TheOpenSI/SmartGate/test_frame.jpg

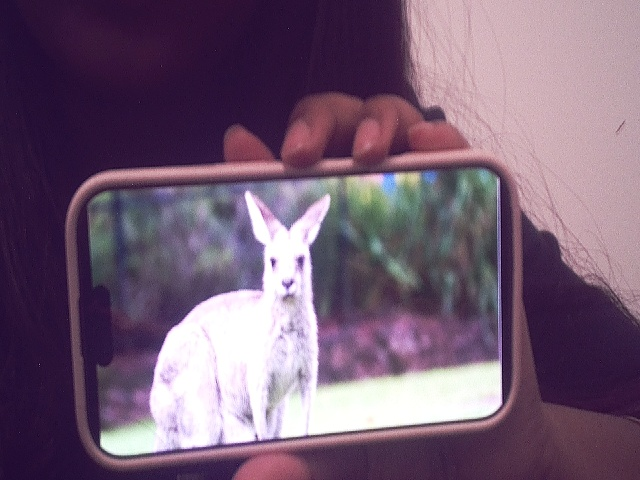
test_frame.jpg
