TheOpenSI/SmartGate/src/web-app/wwwroot/images/oranguton.jpg

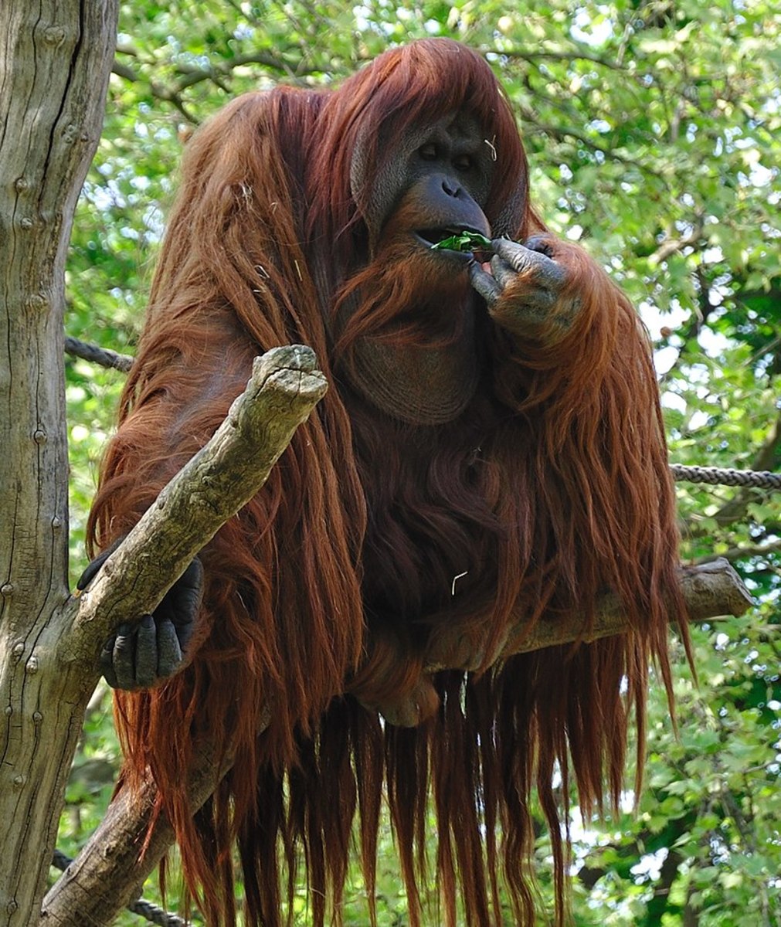
src/web-app/wwwroot/images/oranguton.jpg
