TheOpenSI/SmartGate/src/web-app/wwwroot/images/bongo-antelope.jpg

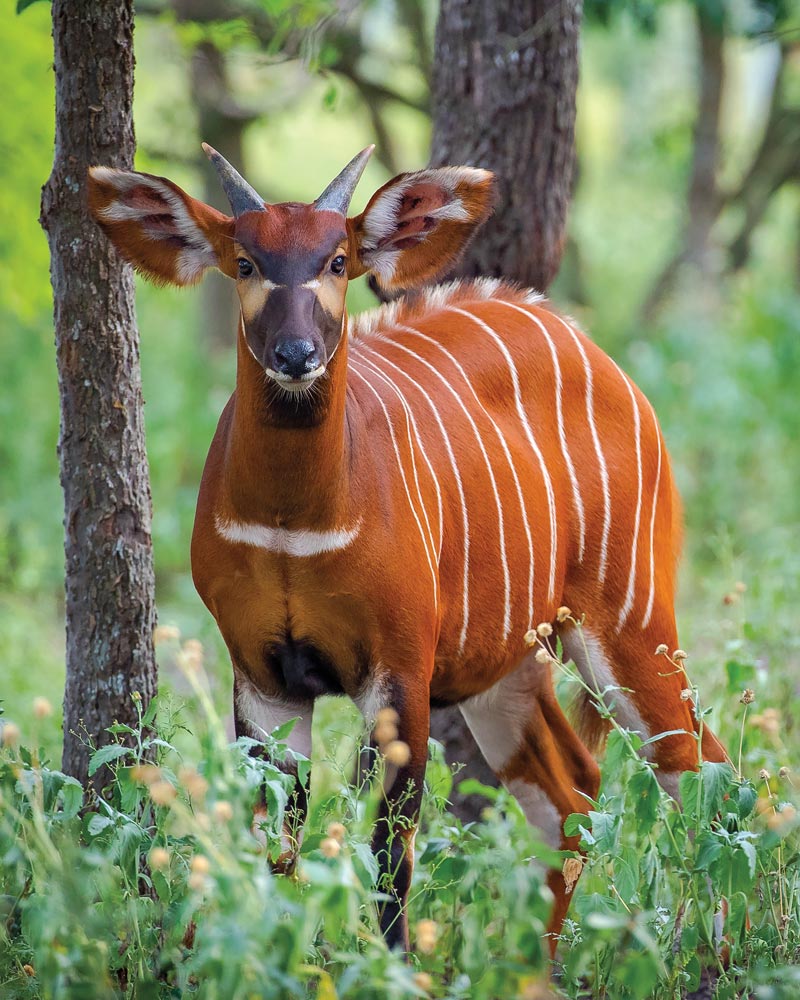
src/web-app/wwwroot/images/bongo-antelope.jpg
