TheOpenSI/SmartGate/src/web-app/wwwroot/images/elephant.jpeg

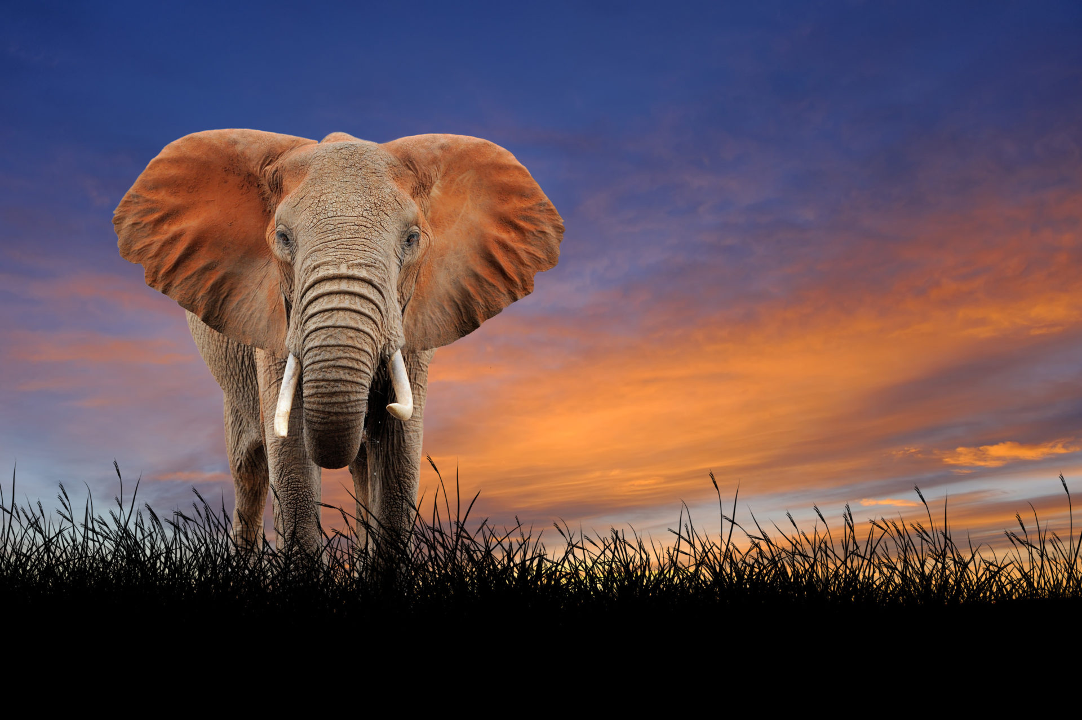
src/web-app/wwwroot/images/elephant.jpeg
