TheOpenSI/SmartGate/src/web-app/wwwroot/images/forest-background.jpg

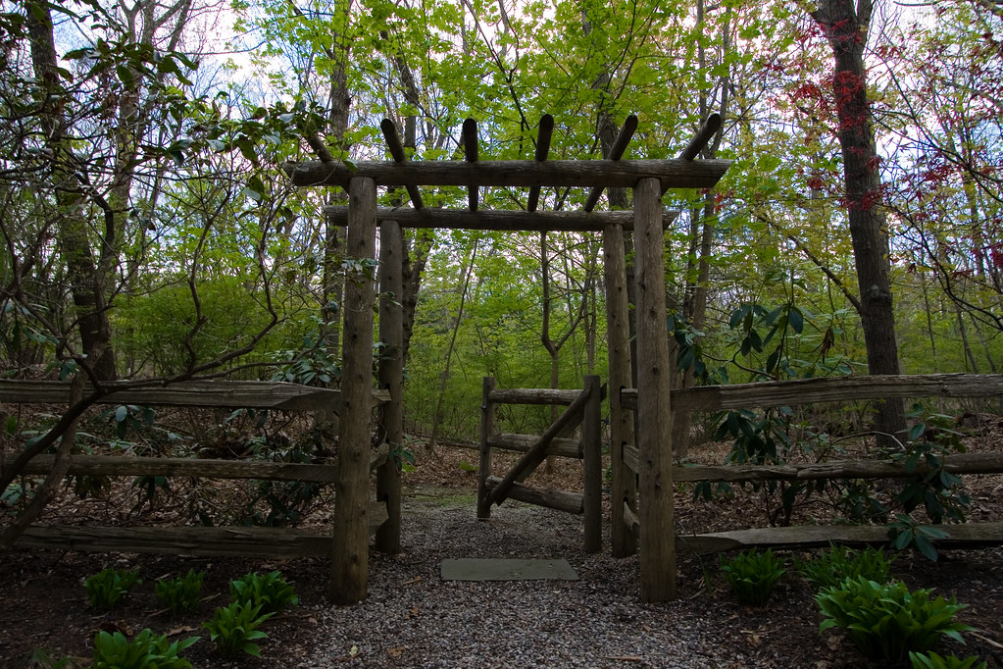
src/web-app/wwwroot/images/forest-background.jpg
