TheOpenSI/SmartGate/src/web-app/wwwroot/images/panda.jpg

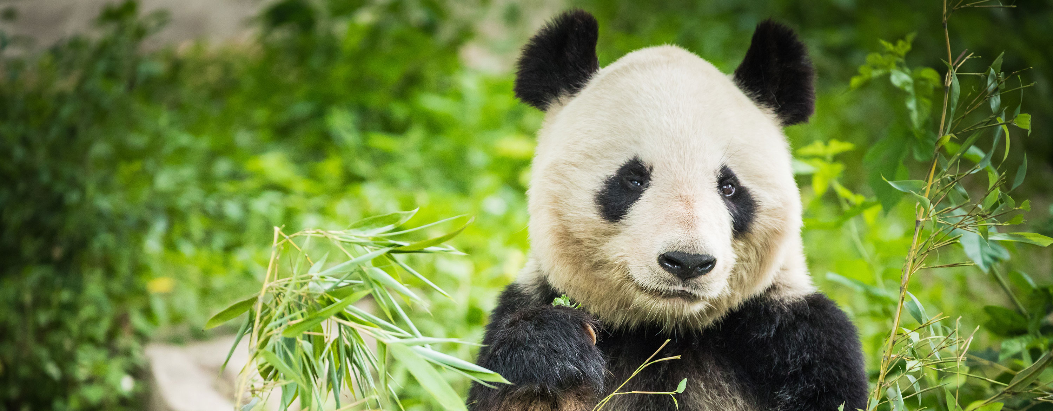
src/web-app/wwwroot/images/panda.jpg
