TheOpenSI/SmartGate/src/web-app/wwwroot/images/red-panda.jpg

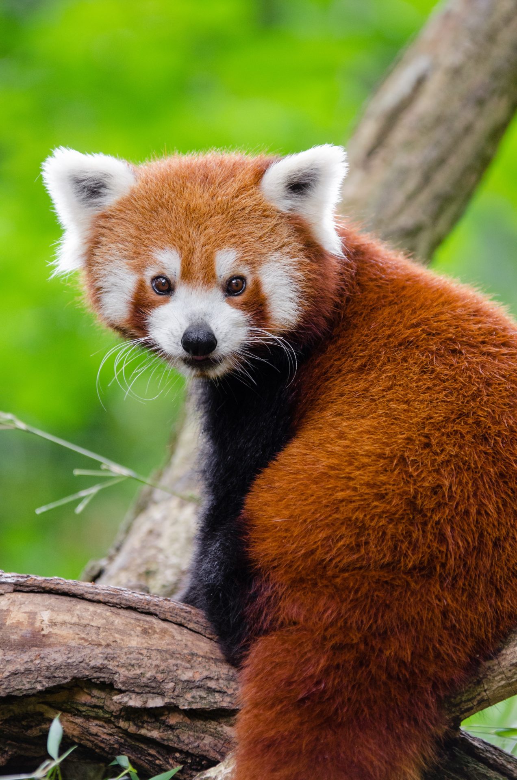
src/web-app/wwwroot/images/red-panda.jpg
