TheOpenSI/SmartGate/src/web-app/wwwroot/images/red-ruffed-lemur.jpg

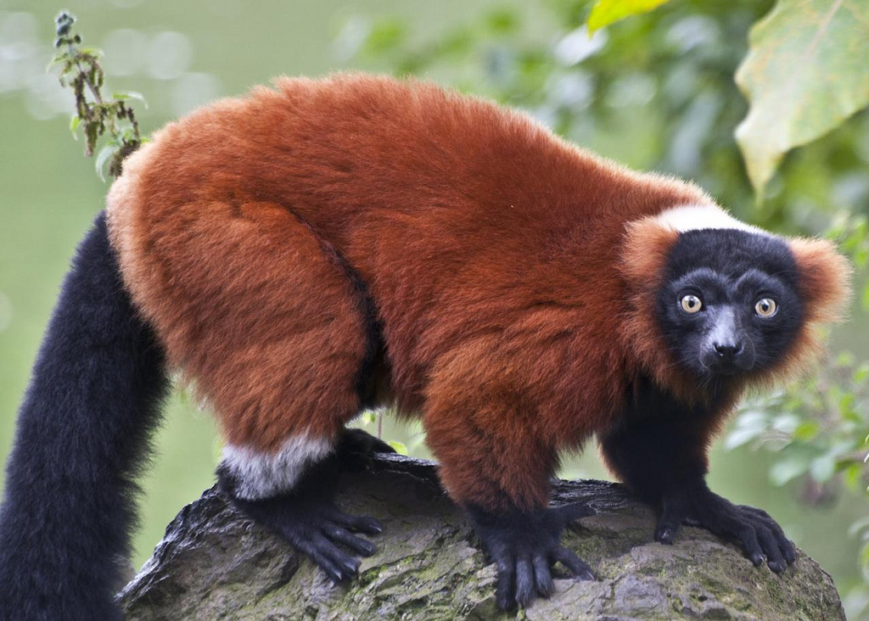
src/web-app/wwwroot/images/red-ruffed-lemur.jpg
