TheOpenSI/SmartGate/src/web-app/wwwroot/images/rihno.jpg

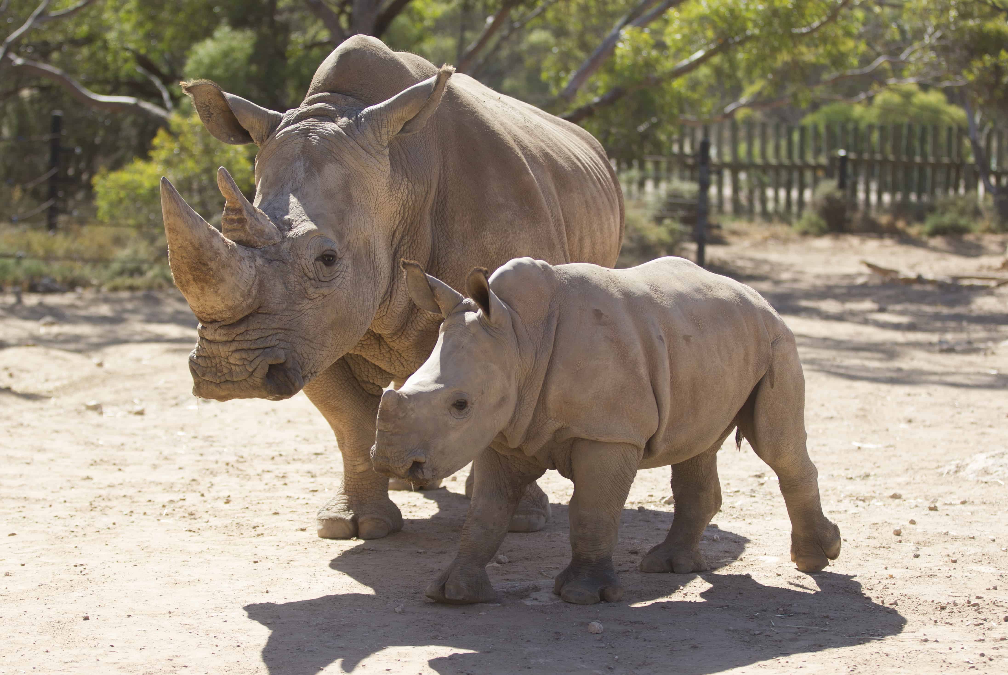
src/web-app/wwwroot/images/rihno.jpg
