TheOpenSI/SmartGate/src/web-app/wwwroot/images/wild_fox.jpg

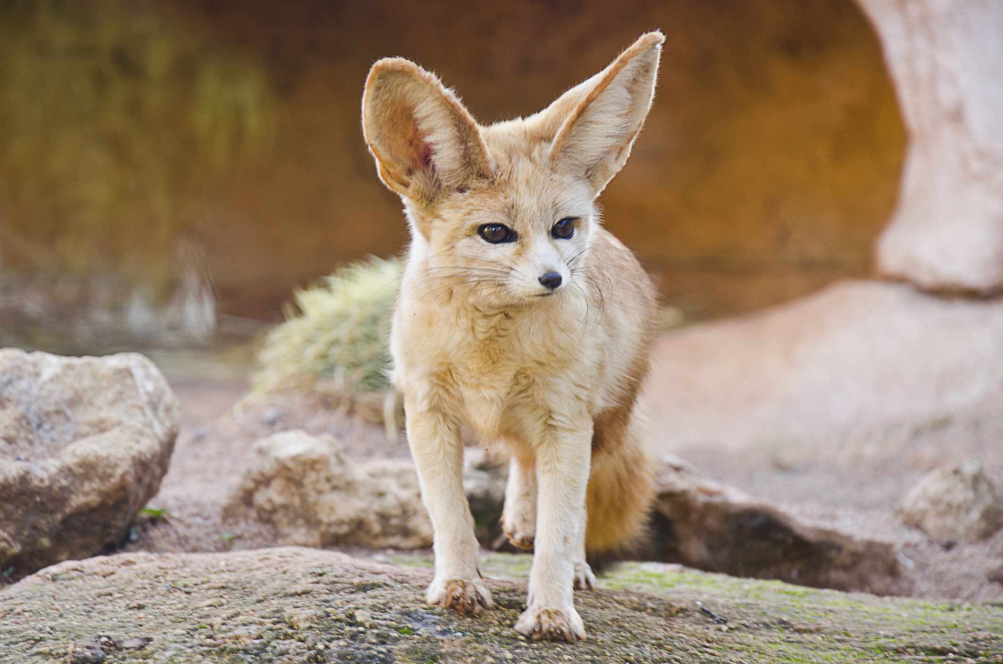
src/web-app/wwwroot/images/wild_fox.jpg
