TheOpenSI/SmartGate/src/web/background_placeholder.jpg

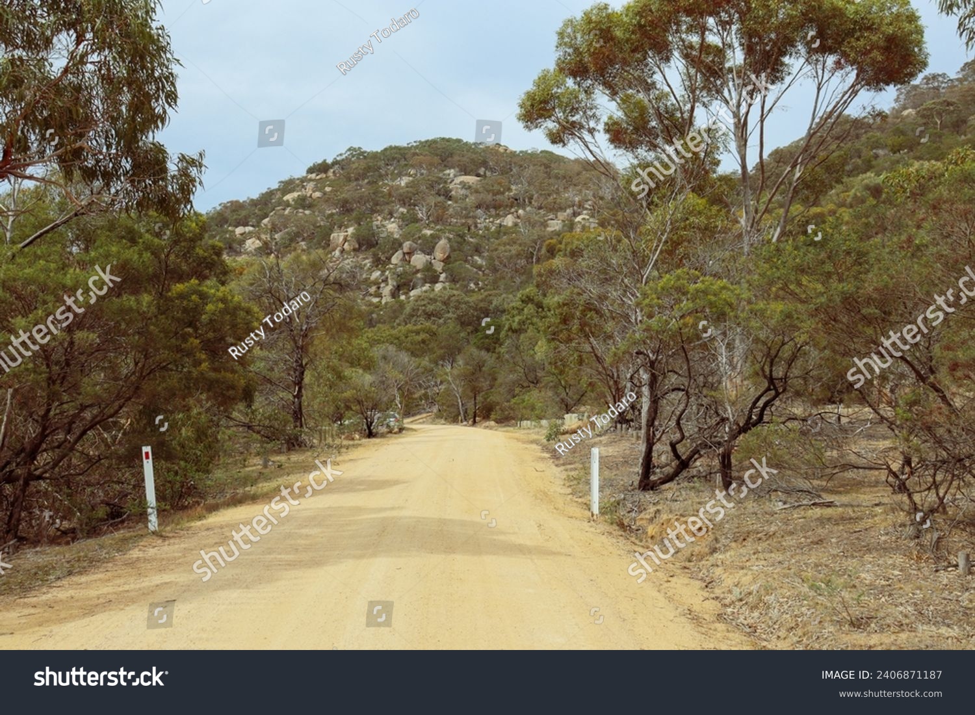
src/web/background_placeholder.jpg
