TheOpenSI/SmartGate/src/web/image1.jpg

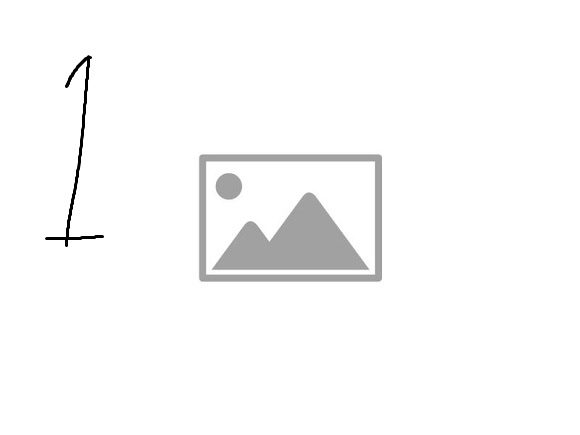
src/web/image1.jpg
