TheOpenSI/SmartGate/src/web/image3.jpg

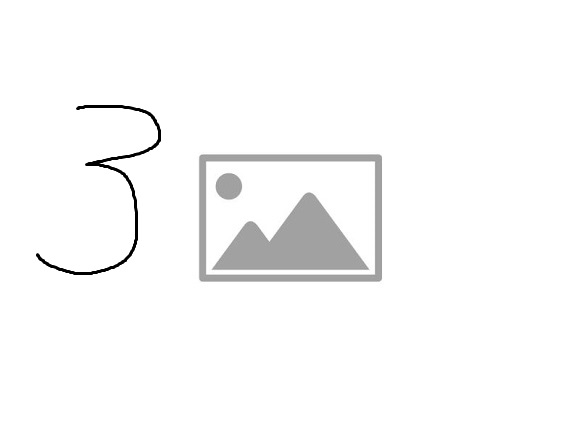
src/web/image3.jpg
