TheOpenSI/SmartGate/Hall_Stand (1).stl

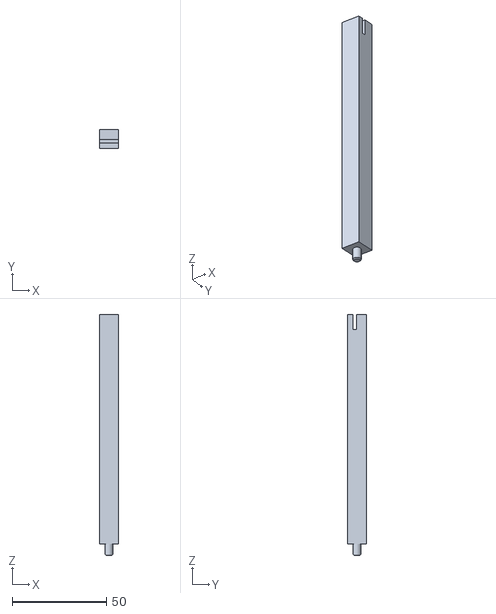
[picture p21: CAD file, 2026-11-12]
Hall_Stand (1).stl
10.0 x 10.0 x 128.0
