TheOpenSI/SmartGate/docs/Schematic_New-Project_2024-10-22.pdf

## HALL EFFECT SENSOR

## HALL EFFECT SENSOR

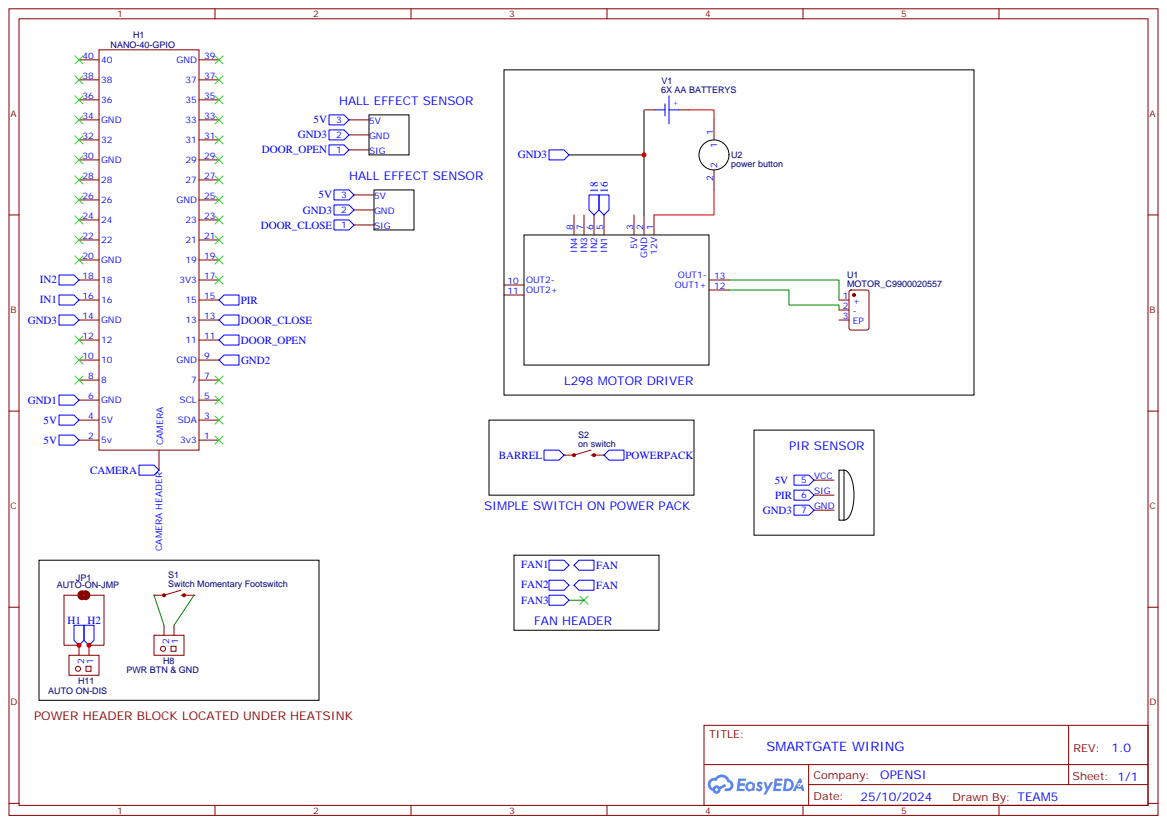
[picture p24: page 1]

SIMPLE SWITCH ON POWER PACK

AUTO ON-DIS
POWER HEADER BLOCK LOCATED UNDER HEATSINK
