TheOpenSI/SmartGate/docs/smartgate Drawing final v4.pdf

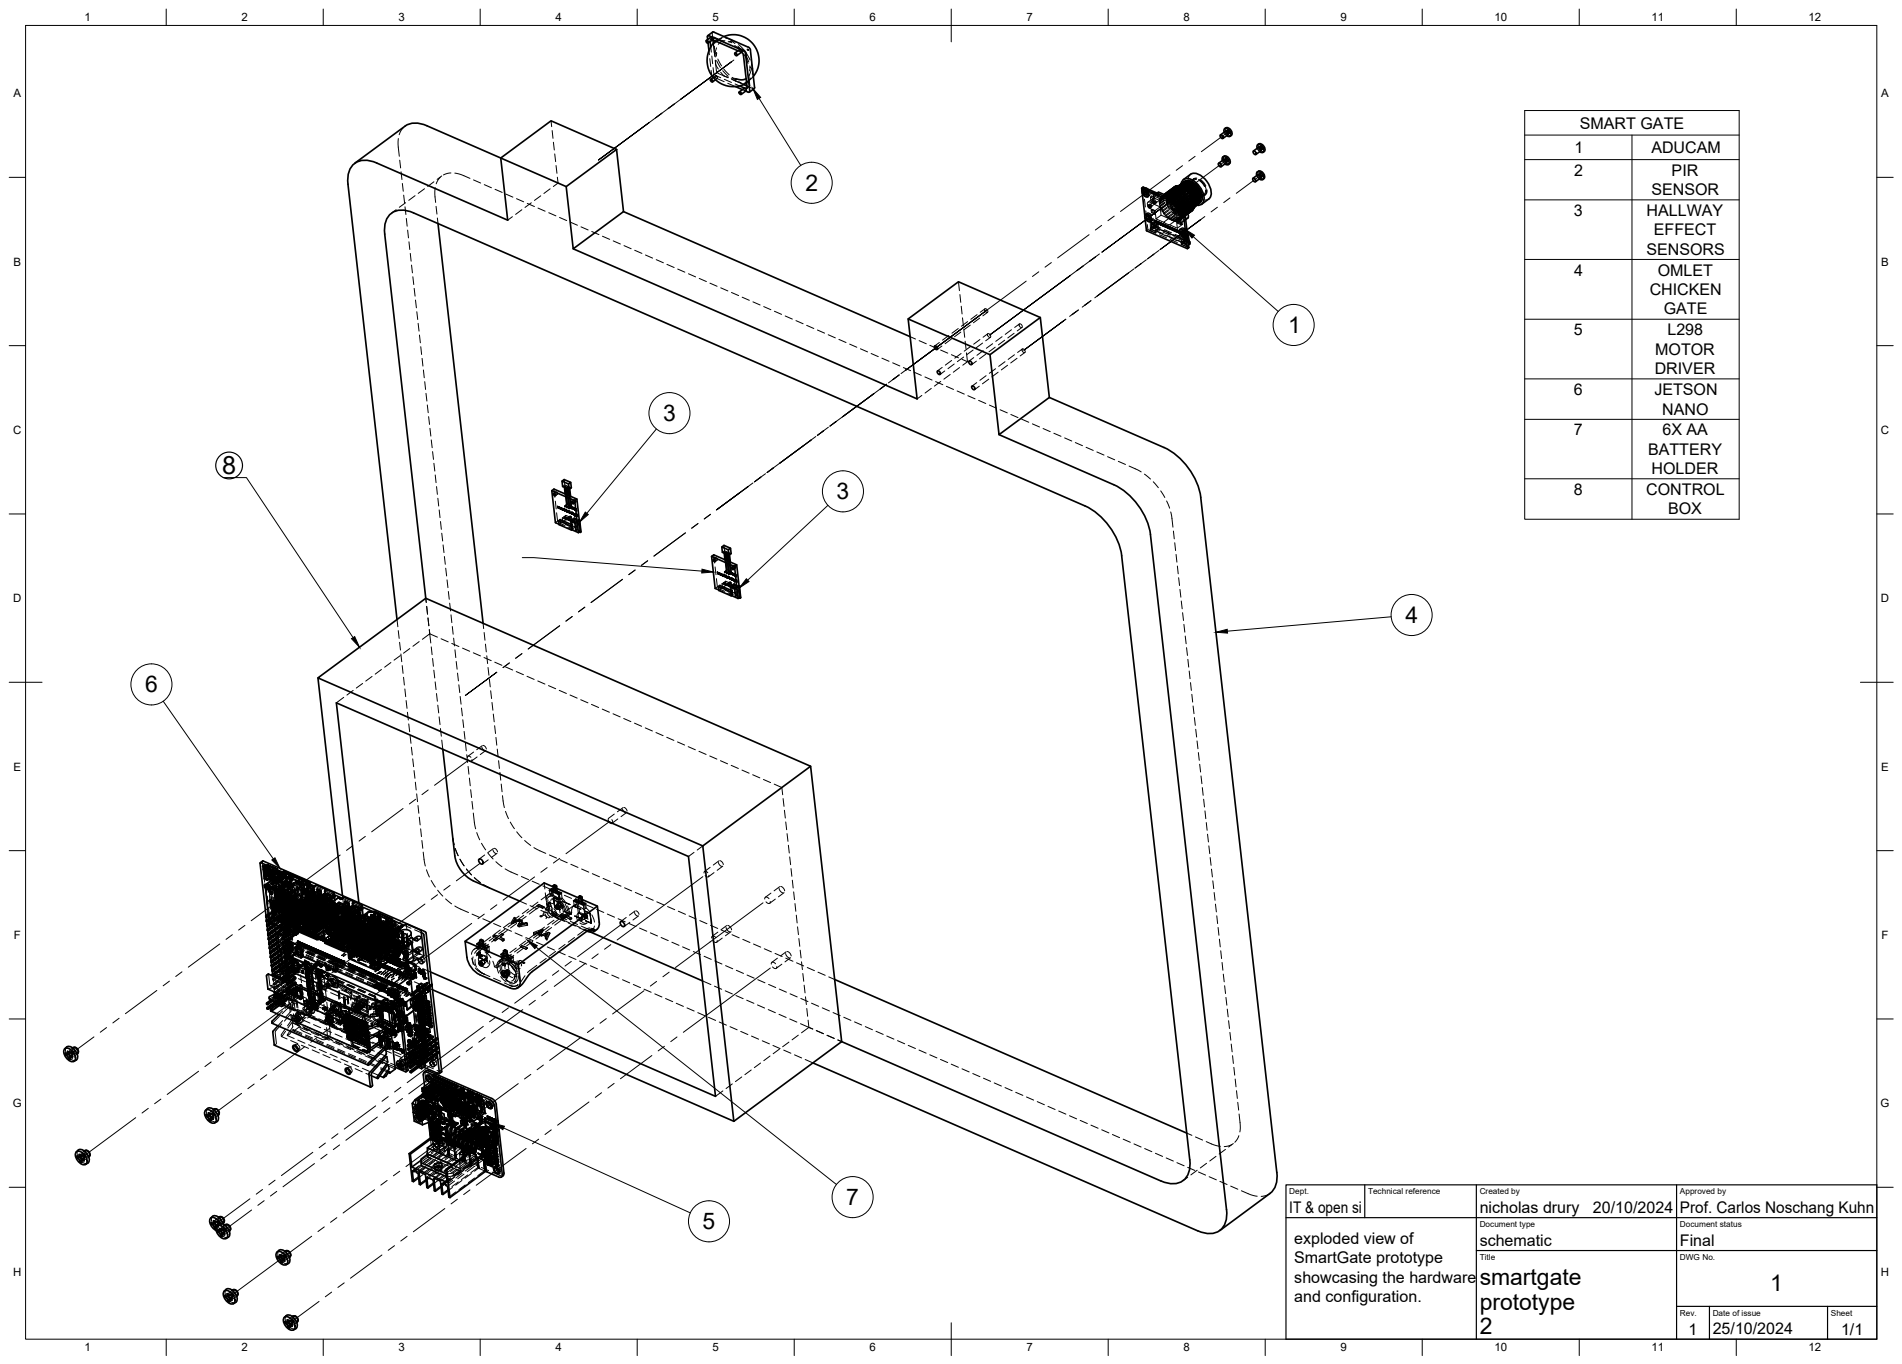
[picture p25: page 1]
12 BACDEFGH; BACDEFGH; Dept.; Technical reference; Created by; Approved by; Document type; Document status; Title; DWG No.; Rev.; Date of issue; Sheet 2; IT & open si; nicholas drury; Prof. Carlos Noschang Kuhn 1 2 3; SMART GATE 1; ADUCAM 2; PIR; SENSOR 3; HALLWAY; SENSORS 4; OMLET; GATE 5; DRIVER 6; JETSON; NANO 7; HOLDER 8; CONTROL; BOX 8

exploded view of
SmartGate prototype
showcasing the hardware
and configuration.
